cwruRobotics/RMC-Battery-Module-2021/README.md

# RMC-Battery-Module-2021

Battery controler PCB card for E-BAY. Holds 12x 18650 cells in 6s2p configuration.
