cwruRobotics/RMC-Battery-Module-2021/(list of files, drawings)

Other design files:
Battery_Management_System.PrjPcb
BMS_Balancer.SchDoc
BMS_Battery_Connections.SchDoc
BMS_Controler.SchDoc
