cwruRobotics/RMC-Battery-Module-2021/(commit log)

2020-11-08 Initial Upload, still a few things to complete
    [BMS_Balancer.SchDoc, BMS_Battery_Connections.SchDoc, BMS_Controler.SchDoc, Battery_Management_System.PrjPcb]
2020-11-08 Finished STM32 connections
    [BMS_Balancer.SchDoc, BMS_Battery_Connections.SchDoc, BMS_Controler.SchDoc]
2020-11-08 Annotated schematics, generated PDF
    [BMS_Balancer.SchDoc, BMS_Battery_Connections.SchDoc, BMS_Controler.SchDoc, Battery_Management_System.PrjPcb]
2020-11-08 Fixed symbol for MOSFETs
    [BMS_Battery_Connections.SchDoc]
2020-11-08 Added changes from design review * Reset jumper from battery monitor to STM32 * VDDA 2.5v reference * SLOT_ID pullup * Thermistor JST connector * I2C internal bus pullups * I2C card edge connector pu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
    [BMS_Balancer.SchDoc, BMS_Battery_Connections.SchDoc, BMS_Controler.SchDoc]
2020-11-13 Added charging cell header for external charger
    [BMS_Battery_Connections.SchDoc, Battery_Management_System.PrjPcb]
2020-11-24 Started work on PCB, added PCB screenshot Also: * Fixed missing footprints on several parts * Fixed missing annotations on two parts * As usual, regenerated schematic PDF
    [BMS_Battery_Connections.SchDoc, BMS_Controler.SchDoc, Battery_Management_System.PrjPcb]
2020-12-19 Worked more on component placement Also: * Moved card-edge connector to edge of board * Added BOM
    [BMS_Battery_Connections.SchDoc, BMS_Controler.SchDoc, BOM.xlsx]
2020-12-24 More routing, parts finally on board
    [BMS_Battery_Connections.SchDoc, BMS_Controler.SchDoc, Battery_Management_System.PrjPcb]
2021-01-10 Preliminary routing completed
    [Battery_Management_System.PrjPcb]
2021-01-11 Begin beefing up battery connections Also: * Organized silk layers
2021-01-13 More work on battery connections, now 4 layers
2021-01-14 Finished routing, added silk labels for jumpers Also: * Fixed pinout of JTAG connector
    [BMS_Controler.SchDoc]
2021-01-14 Updated schematic PDF and STEP file Also: * Added board outline clearance (0.5mm)
2021-01-15 Design Review Changes Details: * Moved J2 (Charge connector) to board edge * Moved LEDs to top-back of board (from top-bottom)
2021-01-16 Generated Gerbers
    [Battery_Management_System.PrjPcb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]
2021-01-17 Fixed drill files, checked gerbers
2021-02-14 Improved GPIO wiring for XALERT
    [BMS_Controler.SchDoc, Battery_Management_System.PrjPcb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]
2021-03-27 Updated schematic PDF
    [Battery_Management_System.PrjPcb]
